TomDeLePolytech/TheProject/RapportS-ances/Seance 2/schema construction.jpg

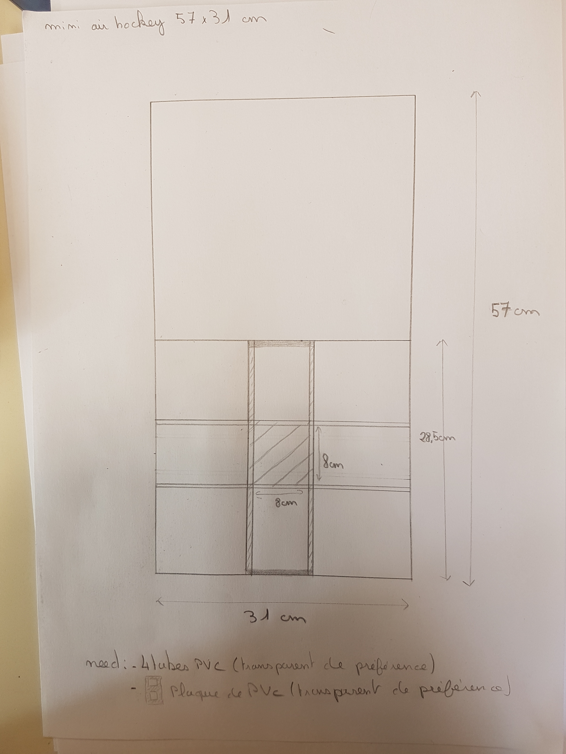
RapportS-ances/Seance 2/schema construction.jpg
