TomDeLePolytech/TheProject/README.md

# TheProject
Le projet Arduino de toute une vie / Un mini air hockey automatisé
