TomDeLePolytech/TheProject/RapportS-ances/Seance 5/Rapport de séance 5 Loic Rizzo.docx

Rapport de séance

Rizzo Loïc G4

Semaine 5 :

Malheureusement nous n’avons toujours pas reçu notre mini air hockey. Néanmoins nous avons commencé à construire l’armature nous permettant de faire la navigation sur le plan xy.

Nous avons fait les dernière découpe de précisions des tubes pvc (lime pour ajuster des quelles millimètre) et des tubes plexiglass.

Nous avons rencontré 1 problème pour coller les plaques de plexiglass entre elles ainsi que le pvc sur le plexiglass.

Pour cela nous nous avons conseillé d’utiliser de l’acetone ou de la colle pvc en contenant.

Après un test moyennent concluant, nous avons essayé de construire l’armature avec la colle pvc, nous la laissons sécher jusqu’à la semaine prochaine pour voir le résultat. En espérant recevoir d’ici-là le mini air hockey.
