TomDeLePolytech/TheProject/RapportS-ances/Seance 4/Rapport de séance 4 Loic Rizzo.docx

Rapport de séance

Rizzo Loïc G4

Semaine 4 :

Le rapport de stage de cette semaine est très léger.

En effet, j’ai passé la plupart de la séance à découper du plexiglass et des tubes de pvc pour pouvoir construire le système présenté dans les rapports de séance de la semaine 2.

Nous avons aussi modifié quelque peu notre programme Arduino car nous avons pu le tester avec 2 moteurs pour simuler le rôle des moteurs à l’intérieur du système.
