TomDeLePolytech/TheProject/RapportS-ances/Seance 3/Rapport de seance 3 Loic Rizzo/Rapport de séance 3 Loic Rizzo.docx

Rapport de séance

Rizzo Loïc G4

Semaine 3 :

Comme nous n’avons pas encore le matériel requis pour commencer la construction de l’armature pour gérer la direction (axe x y ) de la poignet .

Nous avons commencé à réfléchir sur le code Arduino.

Et écrit les première ligne de celui-ci.

Le code et son organigramme serons présent en pièce jointe.

Nous attendons de pourvoir tester celui-ci pour pourvoir faire les modifications nécessaires à son bon fonctionnement.
