TomDeLePolytech/TheProject/RapportS-ances/RapportSéances.md

Dans ce dossier sont déposés les rapports/suivis de chaque séance de développement de notre projet
